inshal8717/HeliosShield_by_FalconEye/hardware/3d-print/CubeSat_2_of_3_Decks_and_Rods.stl

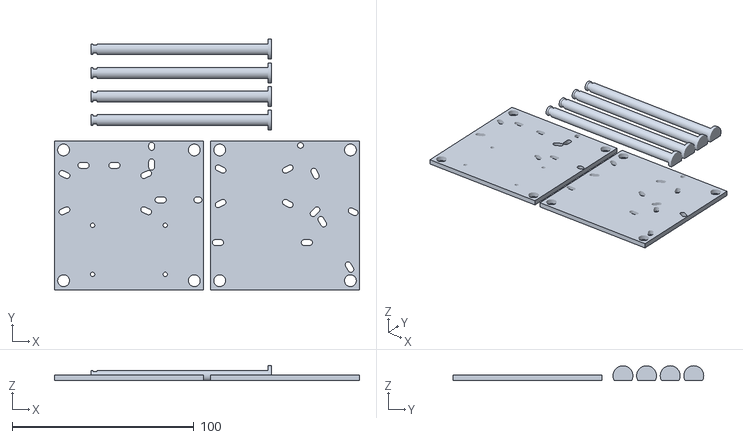
[picture p9: CAD file, 2026-11-08]
hardware/3d-print/CubeSat_2_of_3_Decks_and_Rods.stl
168.0 x 138.0 x 8.00
