inshal8717/HeliosShield_by_FalconEye/hardware/3d-print/CubeSat_3_of_3_Lid_Spacers_Clips.stl

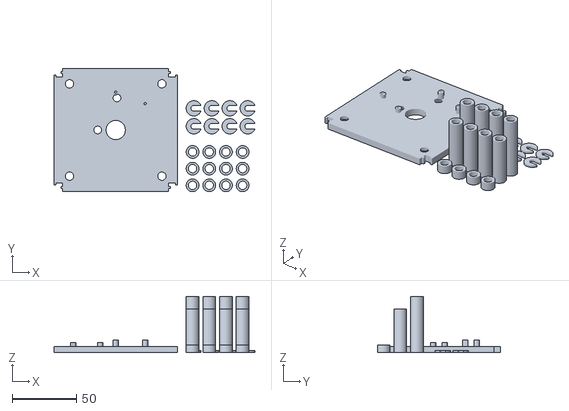
[picture p10: CAD file, 2026-11-08]
hardware/3d-print/CubeSat_3_of_3_Lid_Spacers_Clips.stl
156.6 x 96.2 x 44.0
