inshal8717/HeliosShield_by_FalconEye/hardware/3d-print/CubeSat_1_of_3_Frame_and_BatteryHolder.stl

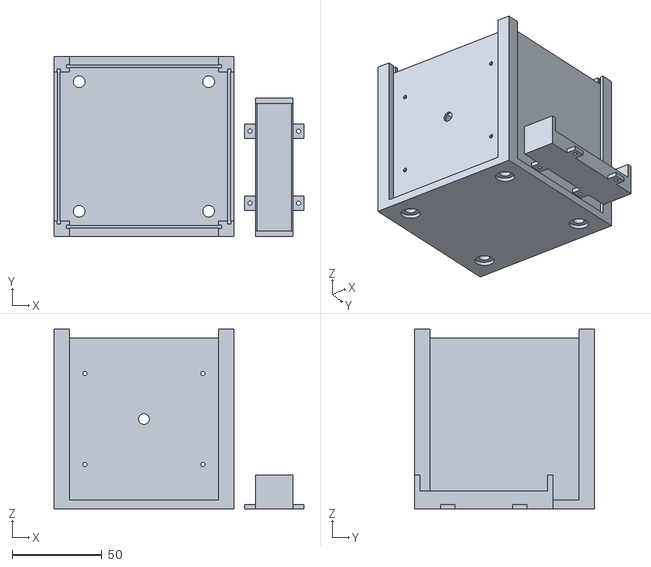
[picture p11: CAD file, 2026-11-08]
hardware/3d-print/CubeSat_1_of_3_Frame_and_BatteryHolder.stl
139.0 x 100.0 x 100.0
