inshal8717/HeliosShield_by_FalconEye/(commit log)

2026-11-03 Stale link, sensor faults, device health and shared storage
    - Link lost: telemetry dims, a NO LINK note shows the packet age, the
    timeline logs "Link lost" and "Link restored"
    - Sensor faults: out-of-range values and stuck sensors are not used as
    data; the gauge, Channels row and status strip read FAULT and the
    timeline logs it
    - Device health row: device name, seq, RSSI, uptime and packet count
    - /api/telemetry stores the latest reading in Upstash Redis when
    UPSTASH_REDIS_REST_URL and UPSTASH_REDIS_REST_TOKEN are set, so every
    serverless instance sees it; falls back to memory otherwise, and
    returns 503 if the store fails
    - Server accepts device, rssi and uptime_s
    - README: packe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
2026-11-03 Remove stuck-sensor warning for steady readings
    A steady temperature (or any non-zero value repeated 15 readings in a row)
    was flagged as a sensor fault with "maybe check temp sensor". Remove that
    rule. Out-of-range checks are unchanged.
    Claude-Session: https://claude.ai/code/session_01Gs39wC4vdQ1fojAJdjL4Uz
2026-11-08 Add full documentation, firmware, enclosure files and report figures
    - README: team, mission and mission name, reproduction steps, hardware
    wiring, simulation models, firmware build and UV calibration, dashboard
    deployment, telemetry format, test results and known limits
    - firmware/falconeye_v41: V4.1 ESP32 sketch (secrets left blank)
    - hardware/3d-print: three STL print groups
    - docs/images: intro photo, Tinkercad, Multisim, enclosure and dashboard figures
    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
    [CubeSat_1_of_3_Frame_and_BatteryHolder.stl, CubeSat_2_of_3_Decks_and_Rods.stl, CubeSat_3_of_3_Lid_Spacers_Clips.stl]
2026-11-08 Lead the README with the pitch and add a data-path overview
    - Introduction now opens with the mission pitch and states what the
    repository does and does not claim
    - Display the intro photo at 360 px wide, centred
    - Add a data-path diagram and the report's dashboard figure with its caption
    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
2026-11-08 Restructure documentation: short README plus docs/ pages
    README is now the front page: team, mission, pitch, at-a-glance table,
    data path, status summary and an index. Detail moves to docs/: mission,
    architecture, subsystems, interfaces, verification, operations, build
    guide, limitations and glossary. Budgets are left out until measured.
    Corrects the dashboard's missing-field behaviour (labelled SIM, not a
    partial-live state).
    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
